cbm-instructions/cbn/images/complete.JPG

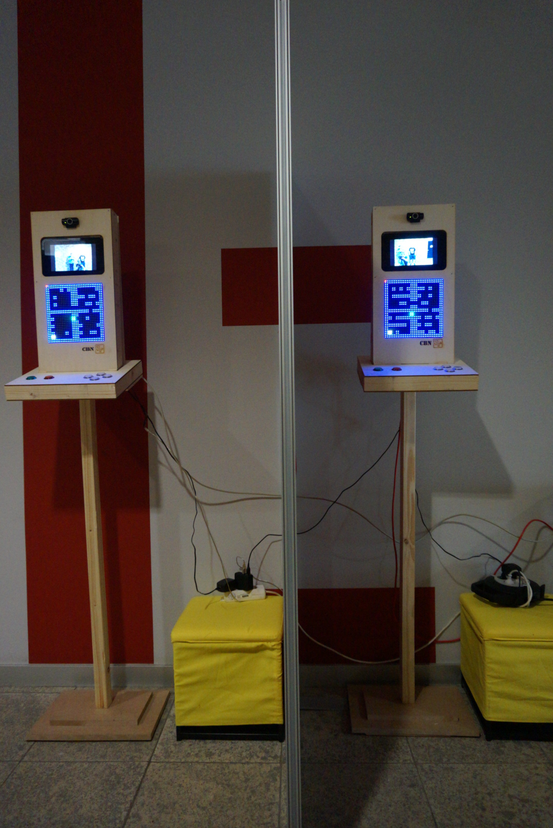
images/complete.JPG
