cbm-instructions/cbn/(commit log)

2017-06-27 add images arduino
2017-06-27 update button image
2017-06-27 button image
2017-06-29 Update Readme.md with Arduino install guide
